amstan/guitar/body/raw.png

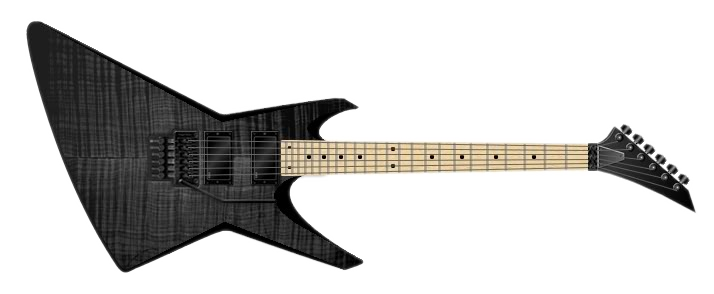
body/raw.png
