amstan/guitar/body/fretskeleton.stl

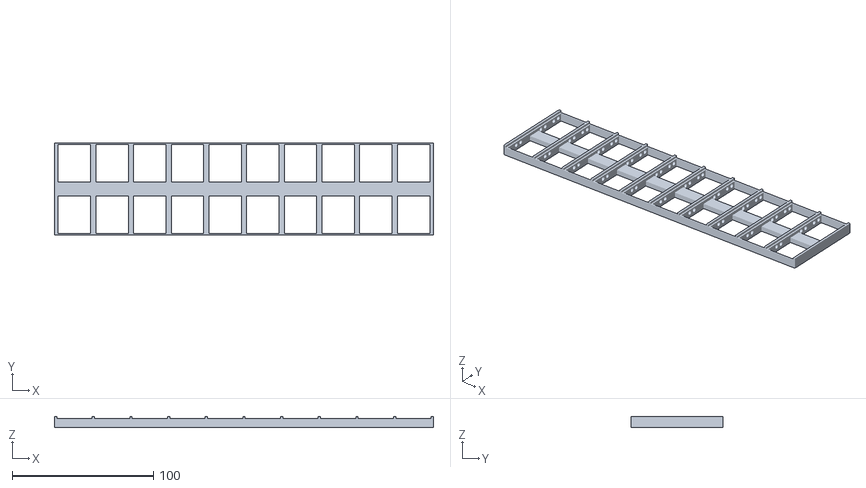
[picture p2: CAD file, 2017-09-04]
body/fretskeleton.stl
268.6 x 65.1 x 8.10
