amstan/guitar/body/neck.stl

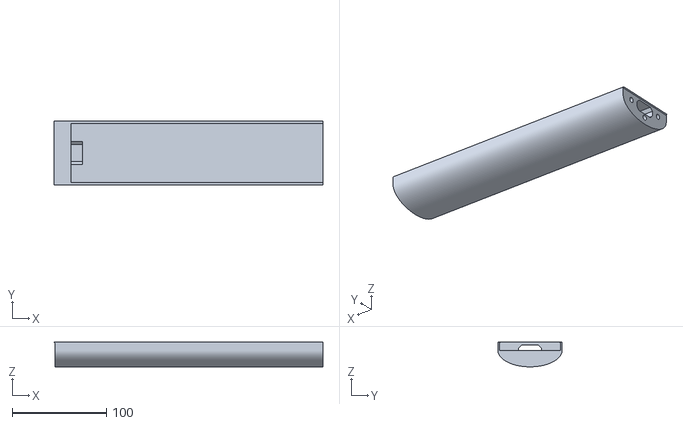
[picture p3: CAD file, 2017-09-04]
body/neck.stl
285.8 x 68.3 x 26.2
