amstan/guitar/body/wifisupport.stl

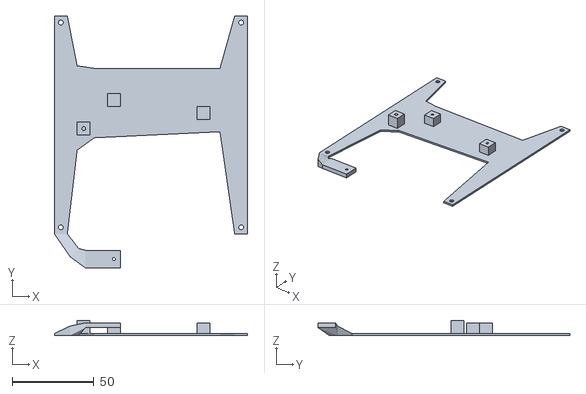
[picture p4: CAD file, 2017-09-04]
body/wifisupport.stl
118.5 x 154.4 x 9.20
