amstan/guitar/body/lid.stl

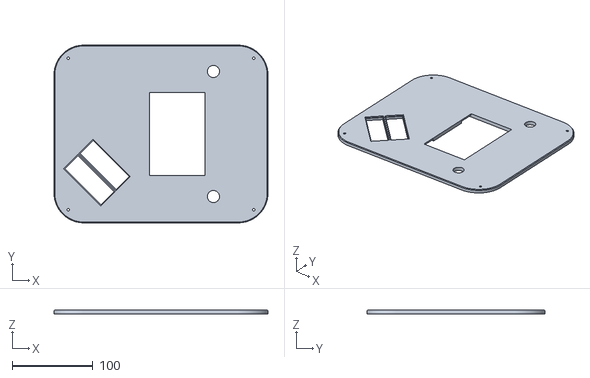
[picture p5: CAD file, 2017-09-04]
body/lid.stl
265.2 x 220.2 x 5.00
