amstan/guitar/body/body.stl

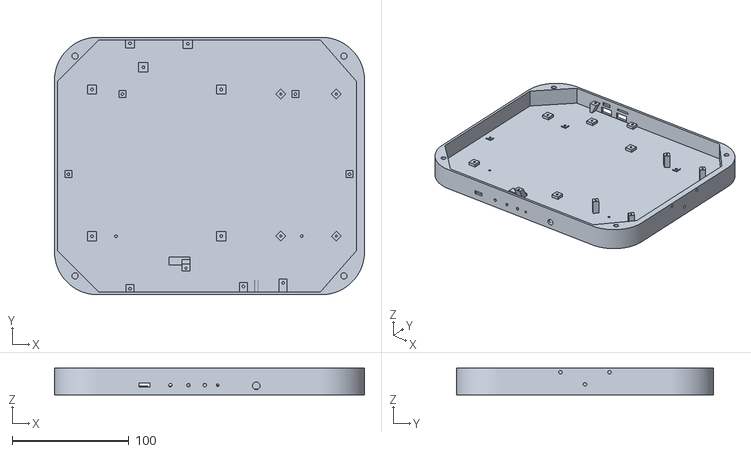
[picture p6: CAD file, 2017-09-04]
body/body.stl
265.2 x 220.2 x 23.0
