amstan/guitar/body/button.stl

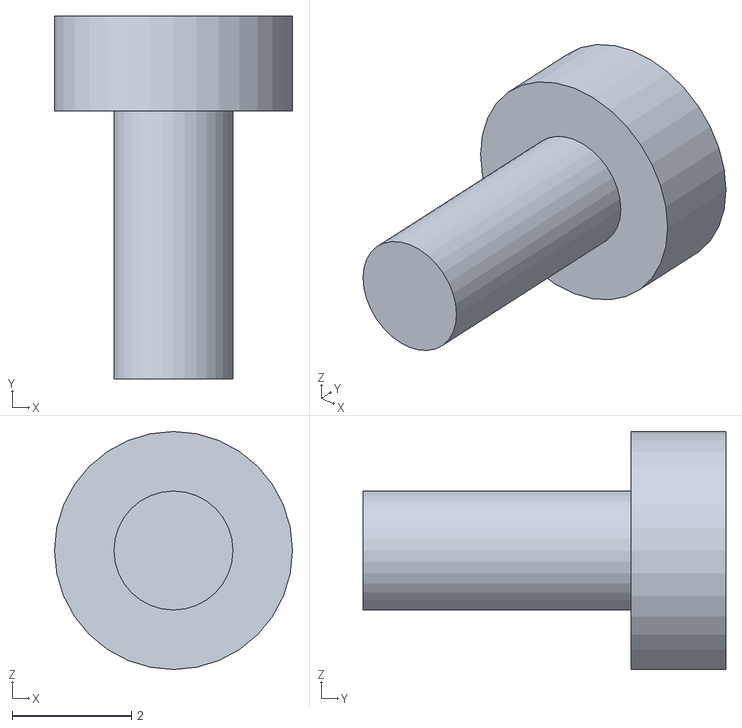
[picture p7: CAD file, 2017-09-04]
body/button.stl
4.00 x 6.10 x 4.00
