amstan/guitar/body/fret_board.stl

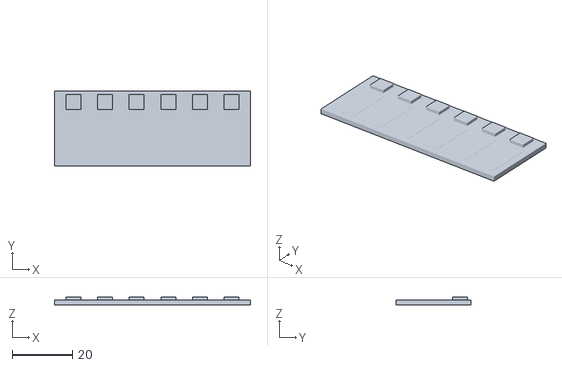
[picture p8: CAD file, 2017-05-14]
body/fret_board.stl
65.0 x 25.0 x 2.60
