amstan/guitar/body/fret_plastic.stl

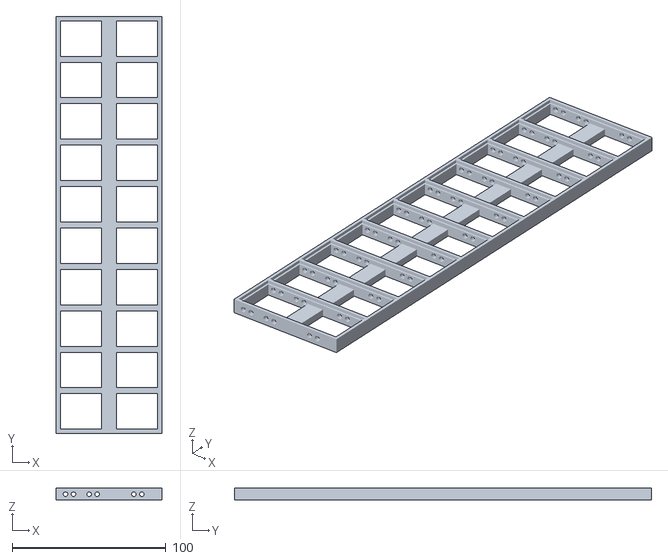
[picture p9: CAD file, 2017-05-14]
body/fret_plastic.stl
68.7 x 270.8 x 8.11
