amstan/guitar/(list of files, cad)

Other CAD files:
body/body.blend
body/fret.blend
body/head.blend
