amstan/guitar/kicad/fret.kicad_pcb

## KiCad design kicad/fret.kicad_pcb (2016-02-22)

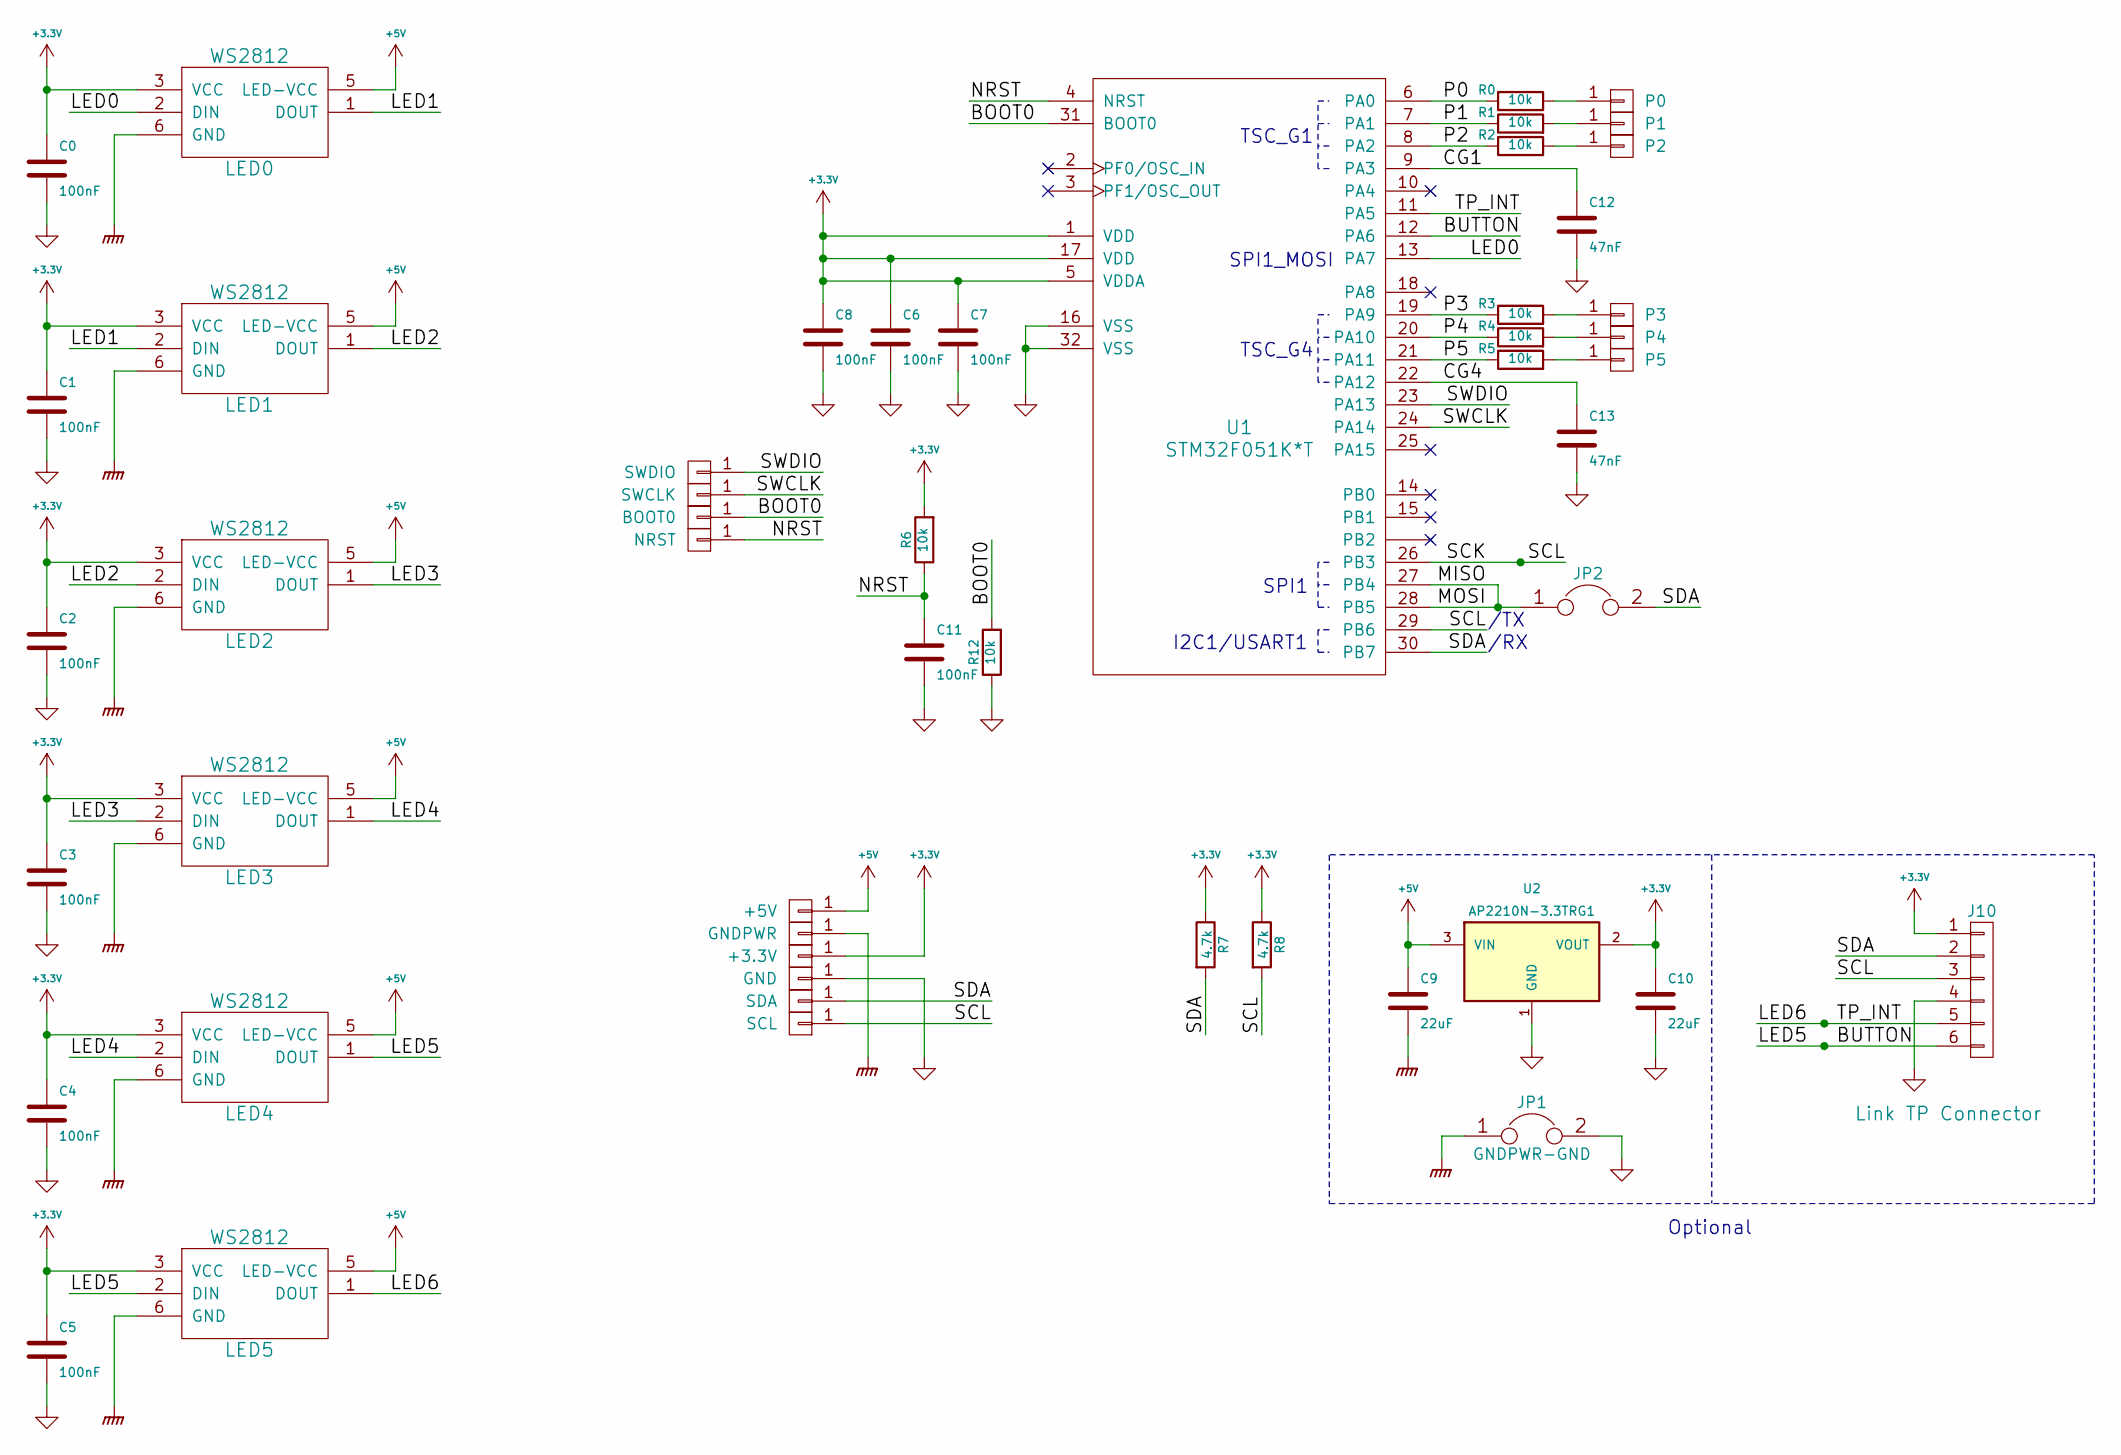
[picture p10: schematic fret.sch, Guitar Fret]

Parts:
C0, C1, C2, C3, C4, C5, C6, C7, C8, C11: 100nF; C_0603; Digi-Key Page 100nF
C9, C10: 22uF; C_0805; Digi-Key Page 22nF
C12, C13: 47nF; C_0603; Digi-Key Page 47nF
J1: +5V; IDC-1x1
J2: GNDPWR; IDC-1x1
J3: +3.3V; IDC-1x1
J4: GND; IDC-1x1
J5: SDA; IDC-1x1
J6: SCL; IDC-1x1
J7: BOOT0; pad-2mm-round; Digi-Key Page n/a
J8: NRST; pad-2mm-round; Digi-Key Page n/a
J9: SWDIO; pad-2mm-round; Digi-Key Page n/a
J10: CONN_01X06; Connector_Molex_PicoBlade_53261-0471; Digi-Key Page todo
J11: SWCLK; pad-2mm-round; Digi-Key Page n/a
JP1: GNDPWR-GND; R_0603; Digi-Key Page 0ohm
JP2: SPI-CONNECTION; R_0603; Digi-Key Page 0ohm
LED0, LED1, LED2, LED3, LED4, LED5: WS2812; 5050-6pin
P0, P1, P2, P3, P4, P5: TOUCH; TP-8x15; Digi-Key Page n/a
R0, R1, R2, R3, R4, R5, R6, R12: 10k; R_0603; Digi-Key Page 10k
R7, R8: 4.7k; R_0603; Digi-Key Page 4.7k
U1: STM32F051K*T; LQFP-32_7x7mm_Pitch0.8mm
U2: AP2210N-3.3TRG1; SOT-23

Connections:
+3V3: C0.1, C1.1, C2.1, C3.1, C4.1, C5.1, C6.1, C7.1, C8.1, C10.1, J3.1, J10.1, LED0.3 (VCC), LED1.3 (VCC), LED2.3 (VCC), LED3.3 (VCC), LED4.3 (VCC), LED5.3 (VCC), R6.2, R7.1, R8.1, U1.1 (VDD), U1.5 (VDDA), U1.17 (VDD), U2.2 (VOUT)
+5V: C9.1, J1.1, LED0.5 (LED-VCC), LED1.5 (LED-VCC), LED2.5 (LED-VCC), LED3.5 (LED-VCC), LED4.5 (LED-VCC), LED5.5 (LED-VCC), U2.3 (VIN)
/BOOT0: J7.1, R12.2, U1.31 (BOOT0)
/BUTTON: J10.6, LED4.1 (DOUT), LED5.2 (DIN), U1.12 (PA6)
/CG1: C12.1, U1.9 (PA3)
/CG4: C13.1, U1.22 (PA12)
/LED0: LED0.2 (DIN), U1.13 (PA7)
/LED1: LED0.1 (DOUT), LED1.2 (DIN)
/LED2: LED1.1 (DOUT), LED2.2 (DIN)
/LED3: LED2.1 (DOUT), LED3.2 (DIN)
/LED4: LED3.1 (DOUT), LED4.2 (DIN)
/LED6: J10.5, LED5.1 (DOUT), U1.11 (PA5)
/MISO: JP2.1, U1.27 (PB4), U1.28 (PB5)
/NRST: C11.1, J8.1, R6.1, U1.4 (NRST)
/P0: R0.1, U1.6 (PA0)
/P1: R1.1, U1.7 (PA1)
/P2: R2.1, U1.8 (PA2)
/P3: R3.1, U1.19 (PA9)
/P4: R4.1, U1.20 (PA10)
/P5: R5.1, U1.21 (PA11)
/SCK: J6.1, J10.3, R8.2, U1.26 (PB3), U1.29 (PB6)
/SDA: J5.1, J10.2, JP2.2, R7.2, U1.30 (PB7)
/SWCLK: J11.1, U1.24 (PA14)
/SWDIO: J9.1, U1.23 (PA13)
GND: C0.2, C1.2, C2.2, C3.2, C4.2, C5.2, C6.2, C7.2, C8.2, C10.2, C11.2, C12.2, C13.2, J4.1, J10.4, JP1.2, R12.1, U1.16 (VSS), U1.32 (VSS), U2.1 (GND)
GNDPWR: C9.2, J2.1, JP1.1, LED0.6 (GND), LED1.6 (GND), LED2.6 (GND), LED3.6 (GND), LED4.6 (GND), LED5.6 (GND)
unnamed: P0.1, R0.2
unnamed: P1.1, R1.2
unnamed: P2.1, R2.2
unnamed: P3.1, R3.2
unnamed: P4.1, R4.2
unnamed: P5.1, R5.2

Notes on the sheet:
Optional
SPI1
I2C1/USART1
/RX
/TX
SPI1_MOSI
TSC_G1
TSC_G4

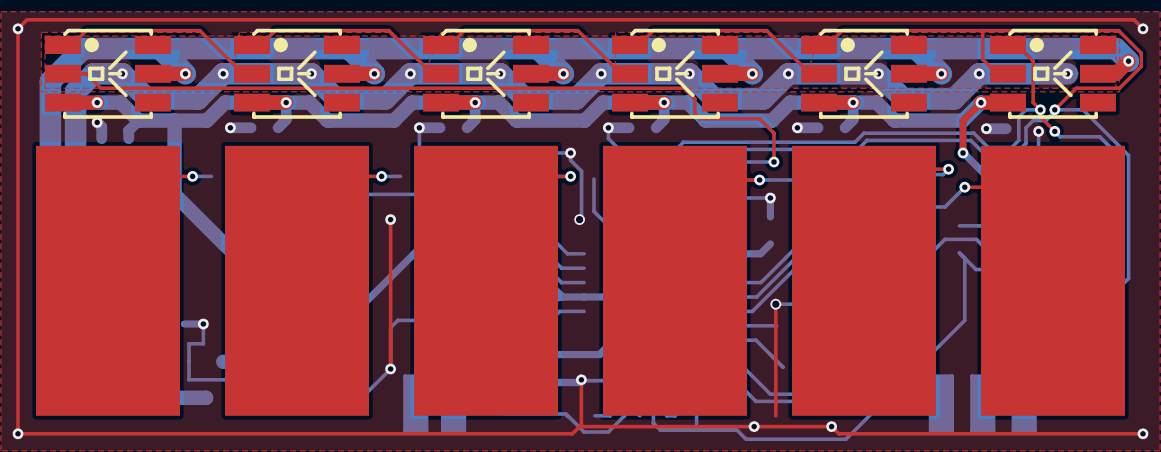
[picture p11: board fret.kicad_pcb from above]

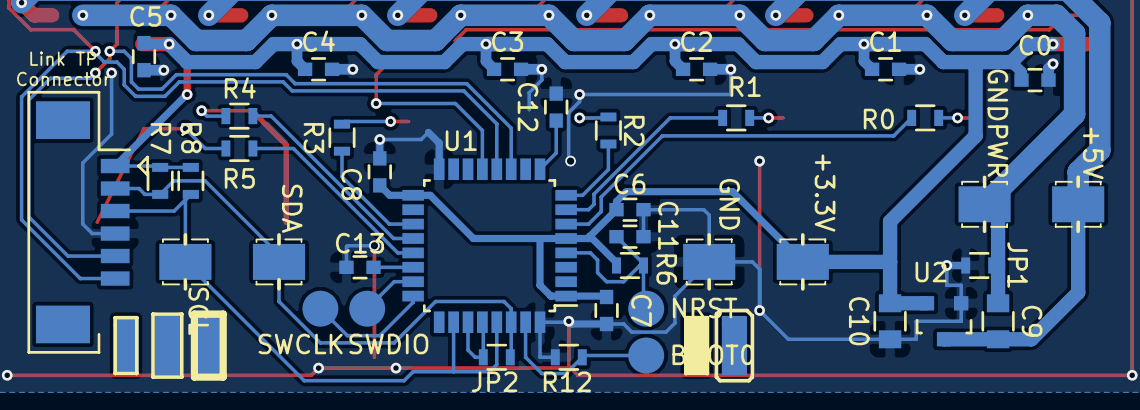
[picture p12: board fret.kicad_pcb from below]

Board: 2 copper layers, 51 parts (39 on the bottom side), 32 nets.
