amstan/guitar/(threads)

Thread 1 (2022-05-16):

Clean up branches

amstan, 2022-05-16:
* `master2` needs to go away.
* `old-master` needs a more semantic name
* `master` needs to have the newest changes, including all the WIP stuff from v2. Perhaps a rename to `main`

amstan, 2022-06-05:
Done
```bash
alex@alex-desktop:~/Projects/guitar (v2)% git branch
  v1
* v2
  v2-fret-circle-playing
  v2-more-i2c-old-board
  v2-oldfirmware-2cdc

alex@alex-desktop:~/Projects/guitar/firmware (v2-cros_ec-master)% git branch
  v2-cros_ec-firmware-gru-8785.B
* v2-cros_ec-master
  v2-cros_ec-split
```

Closed 2022-06-05.

Thread 3 (2022-05-16):

Gather framework shopping list for v3

amstan, 2022-05-16:
Looks like I'm getting a [framework motherboard](https://community.frame.work/c/developer-program/mainboard/133) soon.

I also need a couple more things from their store:
* Battery
* Touchpad?
* Audio board
* Speakers (at least temporarly)
* A bunch of type C modules to test fit
* Ram: 4GB ought to be enough
* SSD: either:
    * cheap nvme
    * usb module (might be easier to debug when it goes wrong?)

amstan, 2022-06-05:
I'm going to buy the [Input](https://frame.work/products/input-cover-kit?v=FRANFC0001) and [Bottom](https://frame.work/products/bottom-cover-kit) cover kits for unrelated reasons, so that will come with the Touchpad, Audio and Speakers. Battery is still a problem to source right now for this project.

Thread 5 (2022-05-16):

Framework touchpad

amstan, 2022-05-16:
I need some kind of input device for the strumming area.

For v2, a laptop touchpad was pretty good.

It would be good to be able to move to the [framework touchpad](https://frame.work/products/touchpad-kit).

The requirement here is to be able to access it rather low level from userspace. At least absolute coordinates for touch events of each of the fingers.

It would be good if it can be accessed using userspace i2c, that way I can even share the bus with the frets. I have a feeling the BIOS currently gobbles up a lot of it, at least based on my experience with PS/2 mouse emulation.

Bonus points if I can get the raw scan matrix before the blob algorithm happens. A custom algorithm to detect which string is affected will probably be better.

amstan, 2022-06-05:
```python
alex@alex-framework:~% sudo python        
Python 3.10.4 (main, May 14 2022, 05:21:19) [GCC 12.1.0] on linux
Type "help", "copyright", "credits" or "license" for more information.
>>> import evdev
>>> dev=evdev.InputDevice("/dev/input/by-path/pci-0000:00:15.3-platform-i2c_designware.2-event-mouse")
>>> a=dev.read_loop()
>>> while True: print(evdev.categorize(next(a)))
...
absolute axis event at 1654412575.038789, ABS_MT_TRACKING_ID
absolute axis event at 1654412575.038789, ABS_MT_POSITION_X
absolute axis event at 1654412575.038789, ABS_MT_POSITION_Y
key event at 1654412575.038789, 330 (BTN_TOUCH), down
key event at 1654412575.038789, 325 (BTN_TOOL_FINGER), down
absolute axis event at 1654412575.038789, ABS_X
absolute axis event at 1654412575.038789, ABS_Y
```

Thread 6 (2022-05-16):

Power + i2c from framework for the frets

amstan, 2022-05-16:
I'm planning to use the v2 frets, at least for now.

Need to figure out where to connect them on a framework motherboard.

[Pinouts.md](https://github.com/FrameworkComputer/Mainboard/blob/main/Electrical/Pinouts.md) Is a pretty good referece, there's a [partial schematic](https://github.com/FrameworkComputer/Mainboard/blob/main/Electrical/Mainboard_Interfaces_Schematic.pdf) too.

Note: we won't have a display or anything on the input cover (except perhaps the touchpad).

I need 3.3V, 5V (~4A) and I2C. So let's brainstorm:
* `I2C`: I want minimum 400kHz, maybe even 1MHz. TS_SDA and TS_SCL seem empty.
* `3.3V`: 3V_TS?
* `5V, 4A`: This one is hard since we have the high current. Motherboard seems to have a 6A smpsu, but I don't know what the current load is.
    * via Input cover
        * `5VS`/`5VALW`, only one pin each
        * `KBL_P`: "High-side 5V PWM by the EC", 2 pins, will need to convince EC to give us 100%
    * Solder to a beefy capacitor on the motherboard directly.
    * regulate our own 5V via `BL_POWER`, which is essentially vbatt.
    * from USB type C, max 3A

amstan, 2022-07-19:
@imnotjames (aka edward) on framework discord was building a breakout board for the display connector containing `TS_{SDA|SCL}`, `TS_3V` and `BL_POWER`.

He also shared this cable that might be useful if I go down that route: https://www.digikey.com/en/products/detail/i-pex/81466-100B-02-D/14312108

Thread 7 (2022-06-05):

Framework MIDI Expansion Card

amstan, 2022-06-05:
For totally random reasons I decided making MIDI expansion card for the framework laptop (hence the v3 guitar) might be a good idea.

Besides the software implementations of various MIDI IO, it would be really complete if we had a physical midi port. Since I don't want to hook into the framework motherboard to grab a UART from the CPU, doing it via USB as a framework expansion card would probably be best.

At first I was concerned about the size, having a 5 Pin DIN would make such a card be huge (even compared to the [upcoming ethernet card](https://frame.work/products/ethernet-expansion-card)). While I do intend to support bigger slots it's really not sexy enough to do DIN.

I recently got into mt32-pi, the [mt32-pi zero](https://ko-fi.com/s/a45005ab04) implements midi as a [3.5mm TRS connector](https://minimidi.world/). Apparently that's even a new [MIDI standard](https://www.midi.org/specifications/midi-transports-specifications/specification-for-use-of-trs-connectors-with-midi-devices-2).

In terms of size, quite a couple TRS connectors might fit on the expansion card. Perhaps even 3 of them (IN, OUT, THRU), or maybe bidirectional.

The IN should have a [circuit](https://github.com/audionerd/minimidi-data/issues/30) to support all types of TRS standards.

A line in might be nice too for other users?
