amstan/guitar/(commit log)

2013-01-28 random program that recieves the power line hum on a highz pad, counts 60 of them, then prints an * every second based on that
2013-07-18 working,high resolution touch reading from capacitive booster pack
2013-07-18 working rgb led
2013-07-23 Started worrying about the body construction again
    [fretspacing.ods]
2014-12-15 Started work on schematics
    [guitar.sch]
2014-12-21 Done switching to a modded jackclient-python
    Helpfully upstream will accept my jackclient changes.
    Everything works except ringbuffers, those are still missing from
    jackclient-python, so a ton of stuff is commented for now.
2015-01-18 Make info and error prints a little better
2015-01-18 note name printing was broken
2015-02-01 added leds
2015-02-02 started looking at stm32f4
2015-02-02 Added sample usb driver from libopencm3
2015-02-02 Working usb printf and timer!
2015-05-20 Making code more compatible with upstream jackclient
    Removed the logging functions from process.c
    Those functions are fugly anyway :) printf is much cleaner.
    error and info also can't be instance methods either (since they belong to the
    whole of jack, not just one client). Made them @staticmethods, even though
    set_*_function eats the callback, it might change in the future.
    The process callback setting was also changed to use the cffi api directly.
    (even though it seemed to kinda work even without changing jackclient,
    it worked probably because cffi was wrapping it in python automatically)
    Also updated the ringbuffer dependency to the newest pull request.
2015-05-20 Implemented touchpad on the stm32, wrote python driver to talk to it.
    Driver help from:
    * http://lxr.free-electrons.com/source/drivers/input/touchscreen/atmel_mxt_ts.c
    * https://github.com/SmokyBob/android_kernel_samsung_u8500/blob/master/drivers/input/touchscreen/atmel_mxt224E_cfg.c
2015-05-20 Hooked up the driver into QGuitarSeq
2015-05-31 kicad: Some more work on the fret schematics
    [guitar.sch]
2015-05-31 kicad: Renamed components library
2015-05-31 kicad: Annotated components
    [guitar.sch]
2015-05-31 kicad: Added netlist
2015-05-31 kicad: renamed guitar to fret
    [fret.sch]
2015-05-31 kicad: Started layout
    [fret.kicad_pcb, fret.sch]
2015-06-21 kicad: almost finished layout with the msp430
    [fret.kicad_pcb, fret.sch]
2015-06-21 kicad: switched fret chip, updated pdfs
2015-06-22 kicad: finished stm32 schematics
    [fret.sch]
2015-06-22 kicad: started fret layout with stm32
    [fret.kicad_pcb, fret.sch]
2015-10-24 kicad: layout was almost finished a while ago
    [fret.kicad_pcb, fret.sch]
2015-10-25 firmware-fret: f072 discovery board blinks
2015-10-25 firmware-fret: working touch sensor
2016-02-20 firmware-fret: tried to get i2c-master working with some sample code
2016-02-20 Revert "firmware-fret: tried to get i2c-master working with some sample code"
    This reverts commit 3976860ca7319e98e007d0c3004bc5db1e932244.
2016-02-20 firmware-fret: working i2c-slave framework
2016-02-21 firmware-fret: now we have i2c registers
2016-02-21 firmware-fret: ws2812 driving
    * Bitbanged/fragile ws2812 driver
    * Hooked up to the register
    * Python tester to make pretty colors
2016-02-22 kicad: Ordered fret board
    Board modifications:
    * SWDIO now in the right spot
    * Silkscreen adjustments
    * Testing touchpad silkscreen edge effects on the backend
    Board is v2.0
    Sent order to elecrow.
    [fret-B.Cu.gbr, fret-B.Mask.gbr, fret-B.SilkS.gbr, fret-F.Cu.gbr, fret-F.Mask.gbr, fret-F.SilkS.gbr, fret-Margin.gbr, fret.drl]
2016-03-02 fret: fret board v2 is alive!
2016-03-24 fret: change i2c to be command based
2016-06-04 Some work in openscad
    [fret.scad]
2016-06-04 Reworking stuff in blender
    [fret.blend, fret_board.stl]
2016-06-06 printed some single ones
    [fret_plastic.stl]
2017-05-04 guitarseq: hooked it up to local i2c
2017-05-14 blender: Preparing to start modifying for the modifier
    [fret.blend]
2017-05-14 blender: Duplicated 10x, applied modifier and filled faces
    [fret.blend]
2017-05-14 blender: 10x ready
    [fret.blend, fret_plastic.stl]
2017-05-14 blender: Finished version with screw holes
    [fret.blend, fret_plastic.stl]
2017-05-14 blender: worked on head
    [head.blend]
2017-05-15 body: found dimensions for top ports
    [body.blend]
2017-05-15 body: just about trying the main baseboard
    [body.blend]
2017-05-17 body: finished wifisupport baseplate
    [body.blend]
2017-05-17 body: done???
    [body.blend]
2017-09-04 body: Finished mk1 for makerfaire
    [body.stl, button.stl, fretskeleton.stl, lid.stl, neck.stl, wifisupport.stl]
2017-09-04 guitarseq: Added touchpad
    Also removed a bunch of stuff that wasn't needed
    since it's now a local device.
2017-09-04 guitarseq: fix case if the message is for the future
